ryhanschutz/robot_arm/cad/Mont1.SLDASM

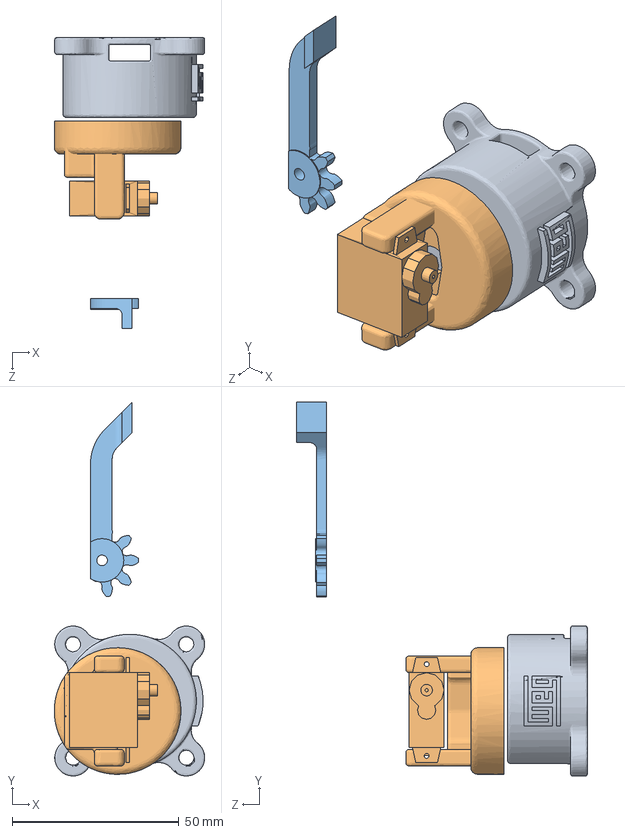
[picture p7: CAD file, 2026-10-29]
cad/Mont1.SLDASM
45.1 x 112.2 x 87.2 mm
base
tampa
garra_esquerda
