ryhanschutz/robot_arm/cad/Mont3.SLDASM

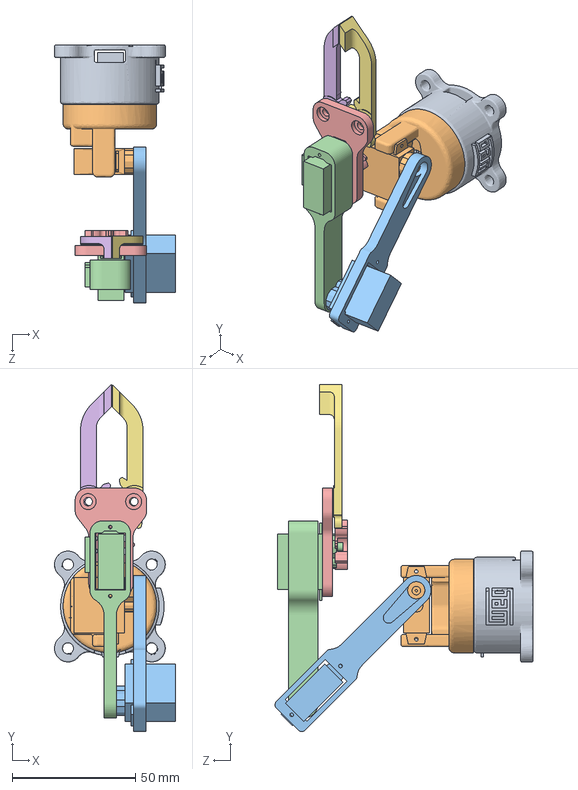
[picture p8: CAD file, 2026-10-29]
cad/Mont3.SLDASM
49.1 x 140.8 x 104.7 mm
base_Servo
tampa
braco_1
braco_2_correto
base_garra
garra_esquerda
garra_direita
