ryhanschutz/robot_arm/cad/garra_esquerda.SLDPRT

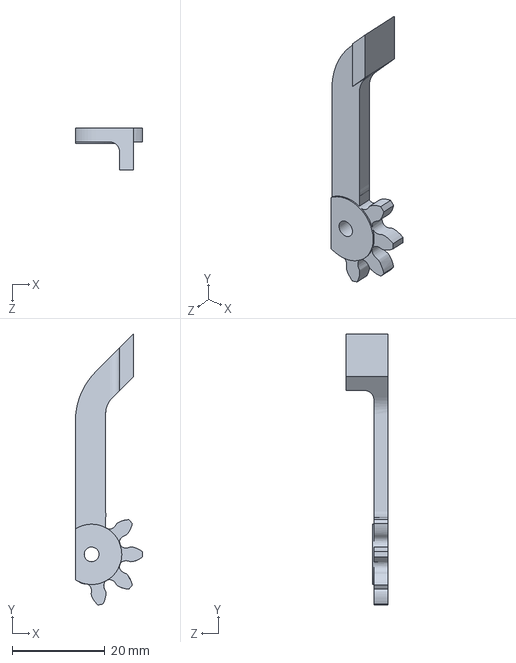
[picture p9: CAD file, 2026-10-29]
cad/garra_esquerda.SLDPRT
14.5 x 58.4 x 9.00 mm
