ryhanschutz/robot_arm/prints/case/caixa_weg.stl

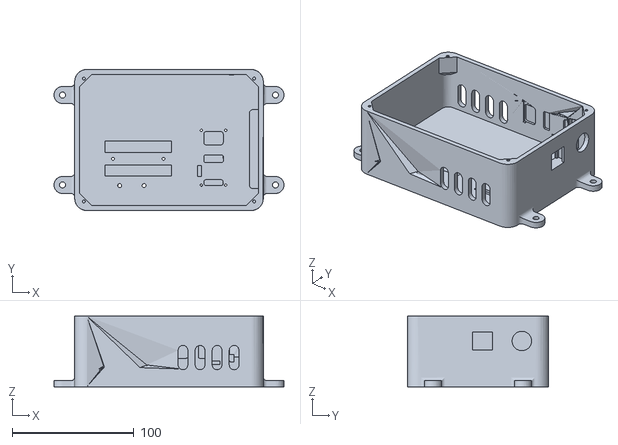
[picture p10: CAD file, 2026-10-29]
prints/case/caixa_weg.stl
189.0 x 115.9 x 58.0
