ryhanschutz/robot_arm/prints/robot/engrenagem_servo_v1.stl

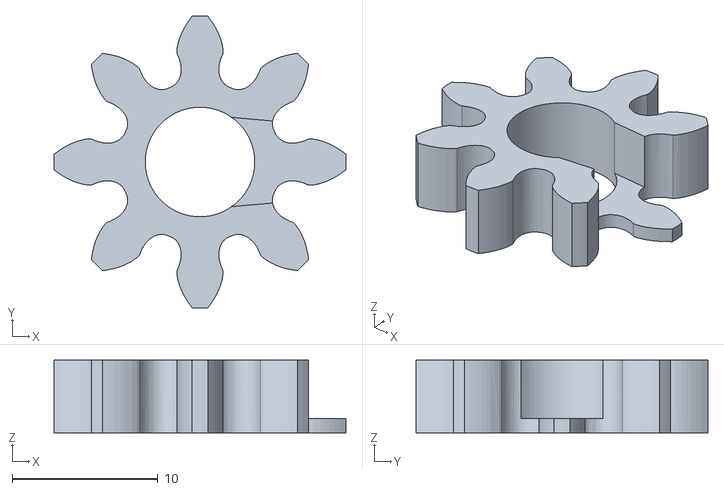
[picture p11: CAD file, 2026-10-29]
prints/robot/engrenagem_servo_v1.stl
20.0 x 20.0 x 5.00
