ryhanschutz/robot_arm/prints/robot/variants/base.stl

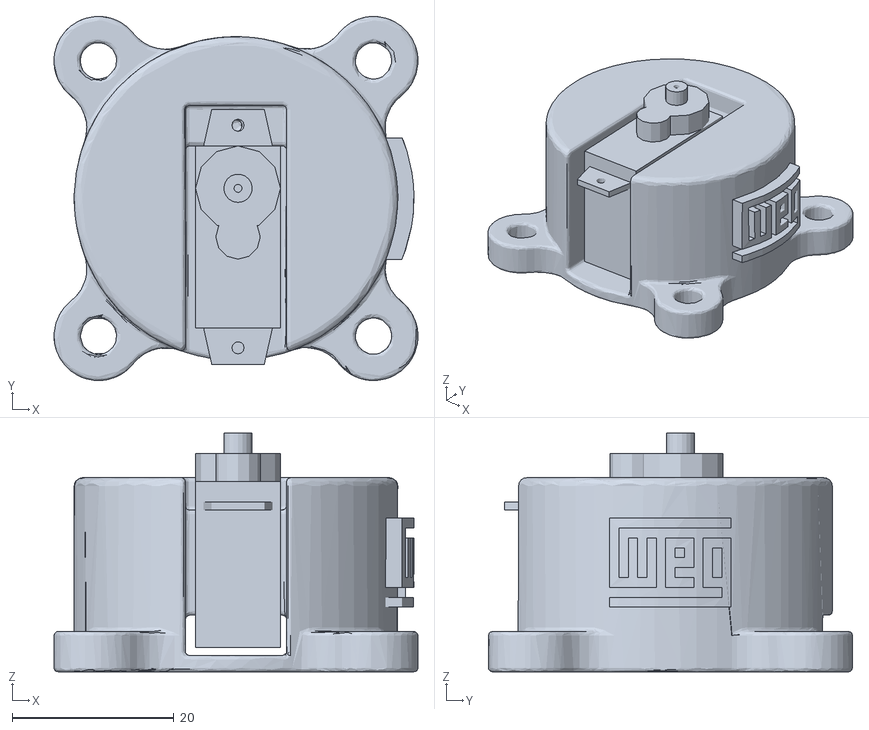
[picture p12: CAD file, 2026-10-29]
prints/robot/variants/base.stl
45.0 x 45.0 x 29.5
