ryhanschutz/robot_arm/cad/base.SLDPRT

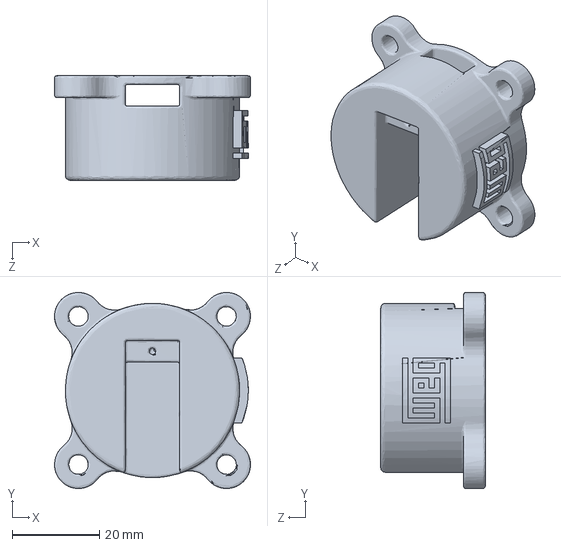
[picture p13: CAD file, 2026-10-29]
cad/base.SLDPRT
45.0 x 45.0 x 24.0 mm
