ryhanschutz/robot_arm/prints/case/tampa_weg.stl

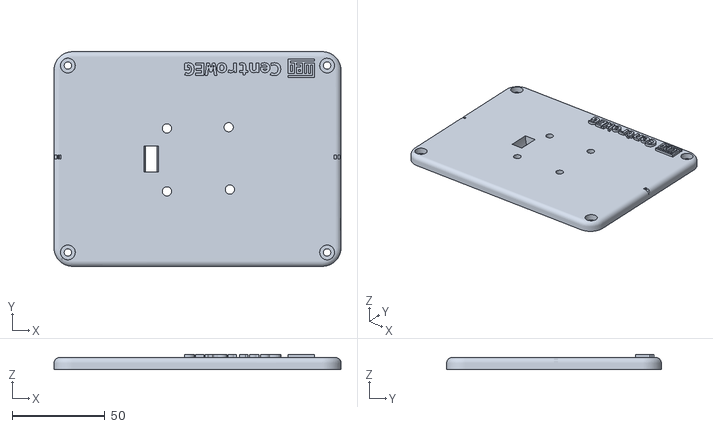
[picture p14: CAD file, 2026-10-29]
prints/case/tampa_weg.stl
155.0 x 115.9 x 8.15
