ryhanschutz/robot_arm/prints/robot/braco_2_v1.stl

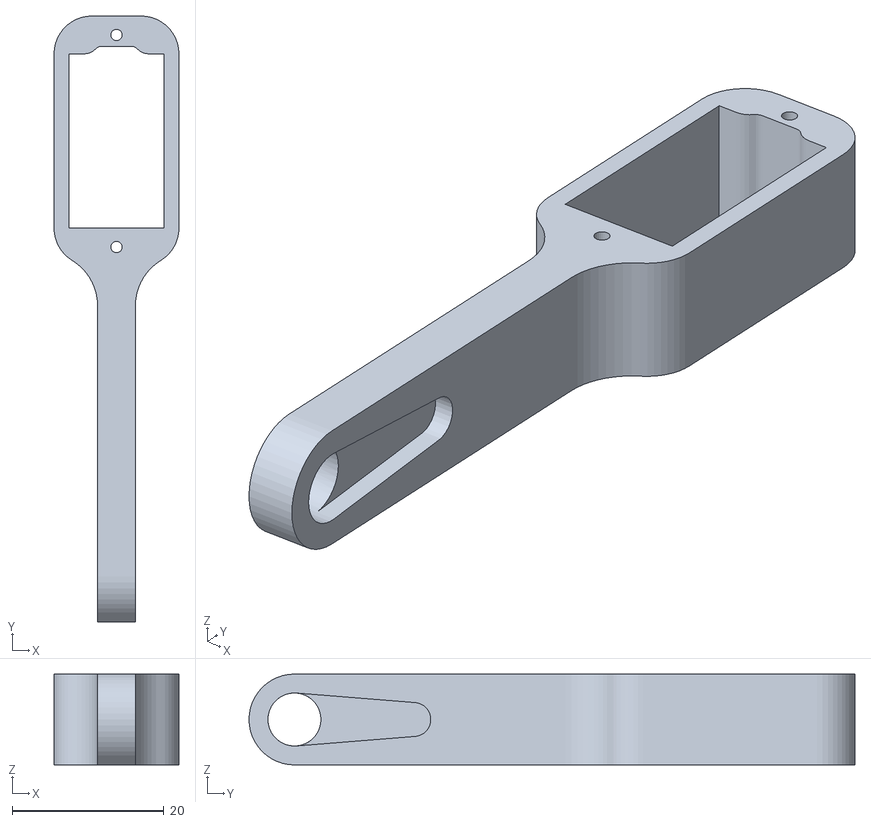
[picture p15: CAD file, 2026-10-29]
prints/robot/braco_2_v1.stl
16.5 x 80.0 x 12.0
