ryhanschutz/robot_arm/cad/tampa.SLDPRT

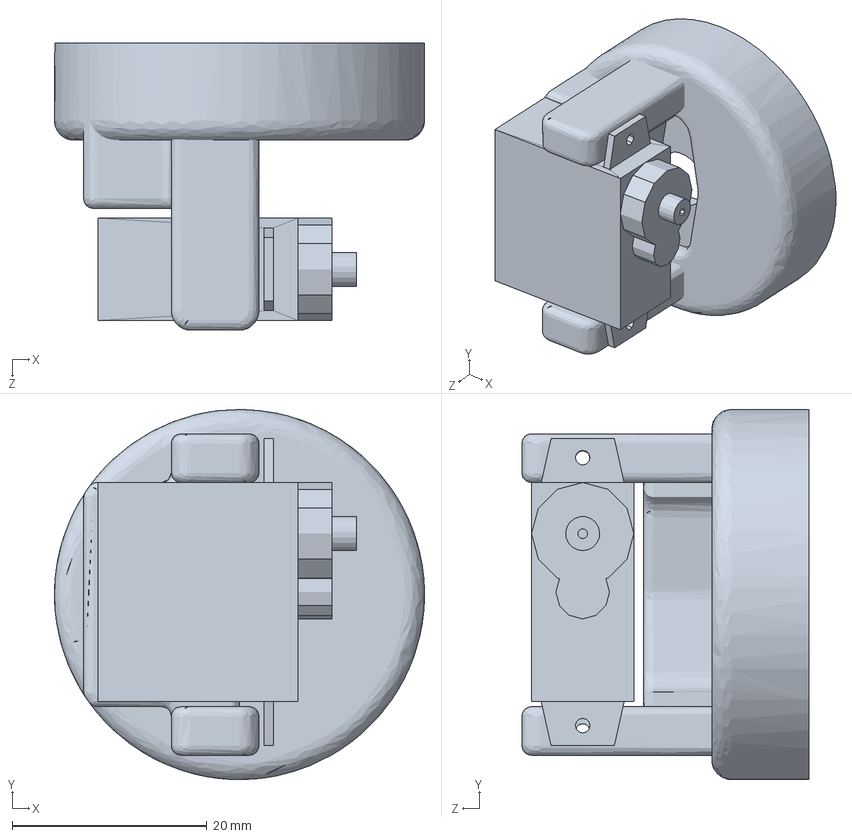
[picture p16: CAD file, 2026-10-29]
cad/tampa.SLDPRT
38.0 x 38.0 x 29.5 mm
