ryhanschutz/robot_arm/prints/robot/variants/base_modificada.stl

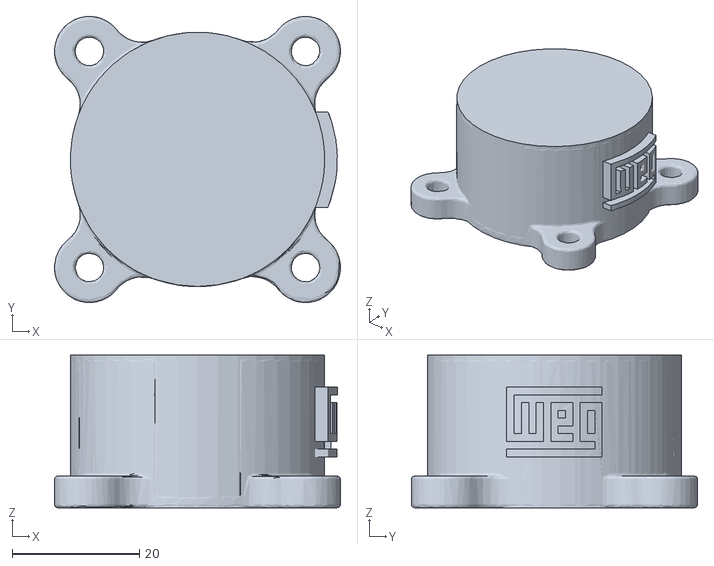
[picture p17: CAD file, 2026-10-29]
prints/robot/variants/base_modificada.stl
45.0 x 45.0 x 24.0
