ryhanschutz/robot_arm/prints/robot/braco_1_v1.stl

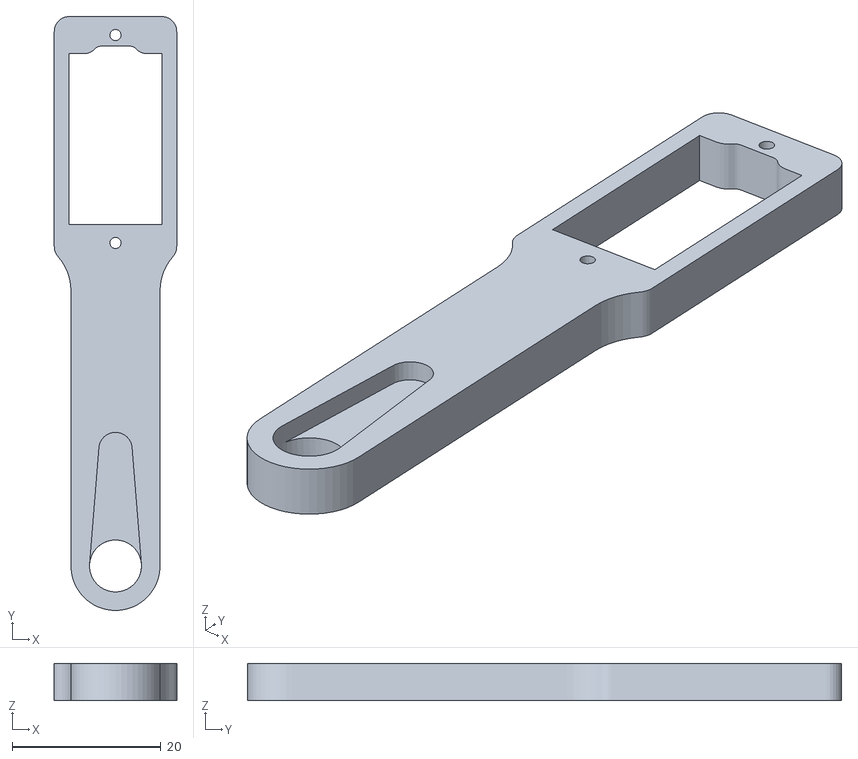
[picture p18: CAD file, 2026-10-29]
prints/robot/braco_1_v1.stl
16.5 x 80.0 x 5.00
