ryhanschutz/robot_arm/meshes/braco_2.stl

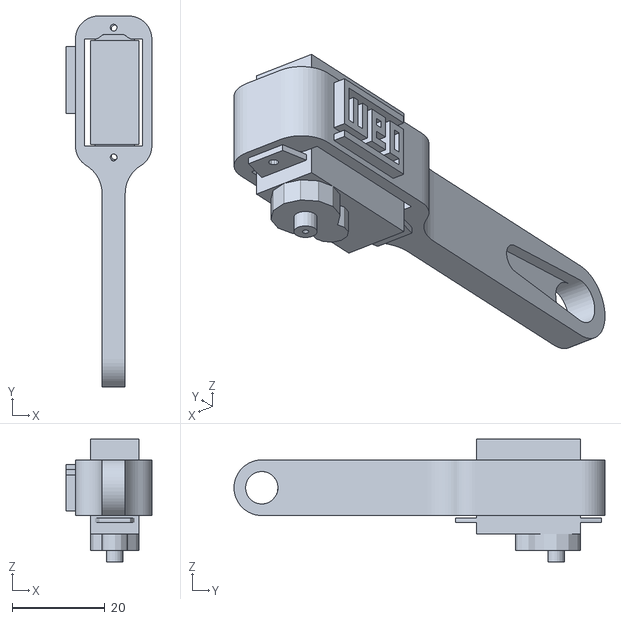
[picture p19: CAD file, 2026-10-29]
meshes/braco_2.stl
18.5 x 80.0 x 26.5
