ryhanschutz/robot_arm/prints/robot/suporte_garra_v1.stl

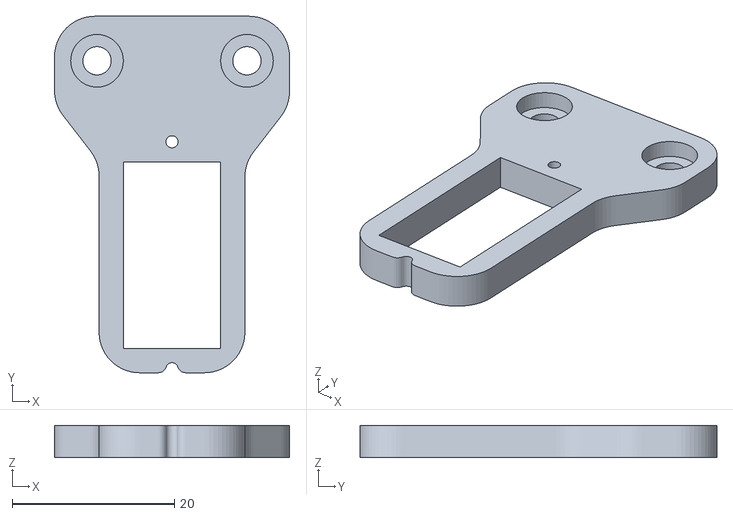
[picture p20: CAD file, 2026-10-29]
prints/robot/suporte_garra_v1.stl
29.0 x 44.0 x 4.00
