ryhanschutz/robot_arm/cad/braco_1.SLDPRT

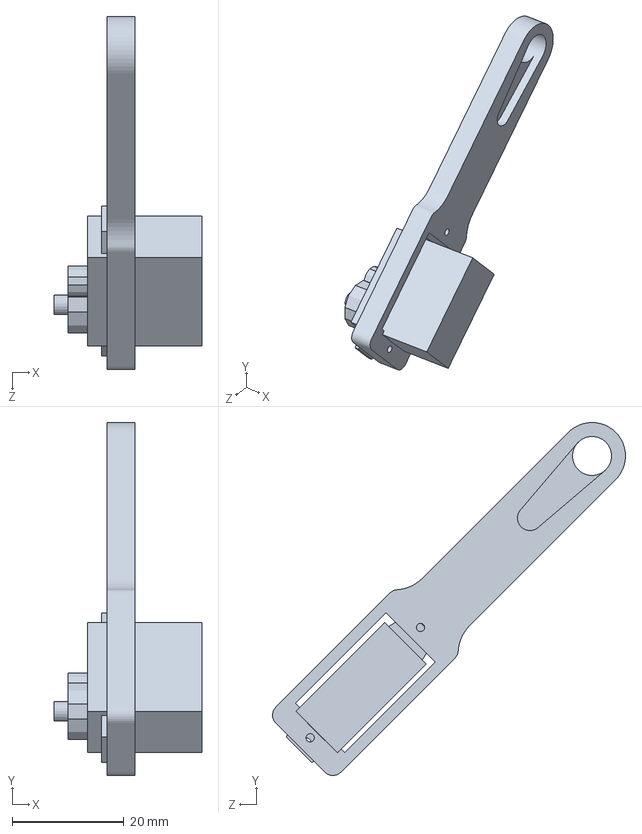
[picture p21: CAD file, 2026-10-29]
cad/braco_1.SLDPRT
26.5 x 63.3 x 63.3 mm
