ryhanschutz/robot_arm/cad/base_garra.SLDPRT

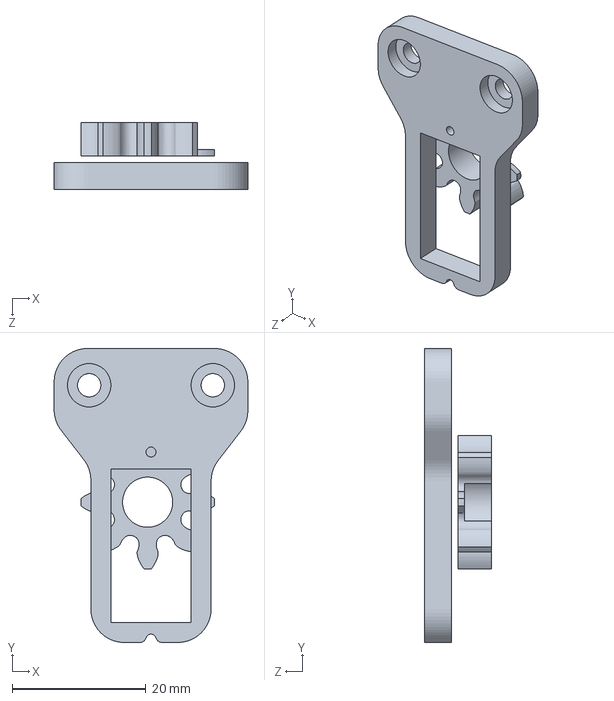
[picture p22: CAD file, 2026-10-29]
cad/base_garra.SLDPRT
29.0 x 44.0 x 10.0 mm
