ryhanschutz/robot_arm/prints/robot/engrenagem_garra_1_v1.stl

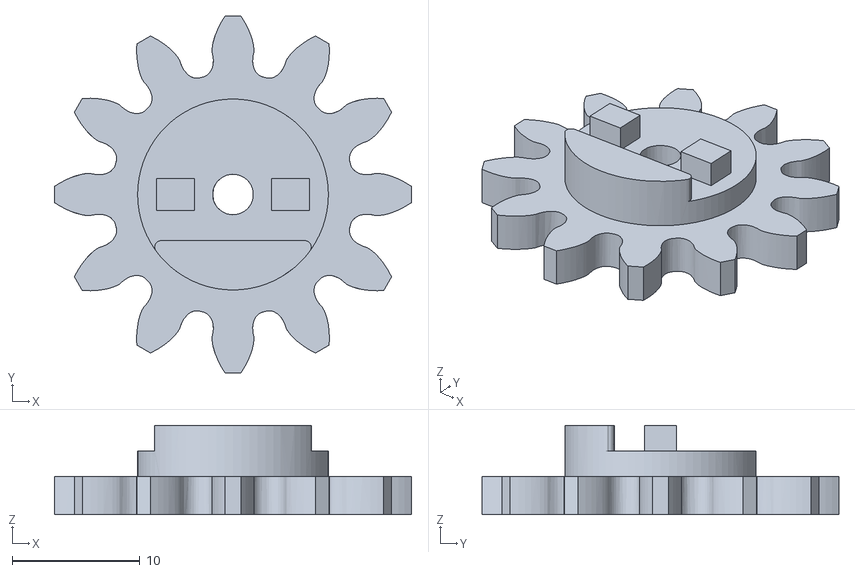
[picture p23: CAD file, 2026-10-29]
prints/robot/engrenagem_garra_1_v1.stl
28.0 x 28.0 x 7.00
