ryhanschutz/robot_arm/cad/braco_2_correto.SLDPRT

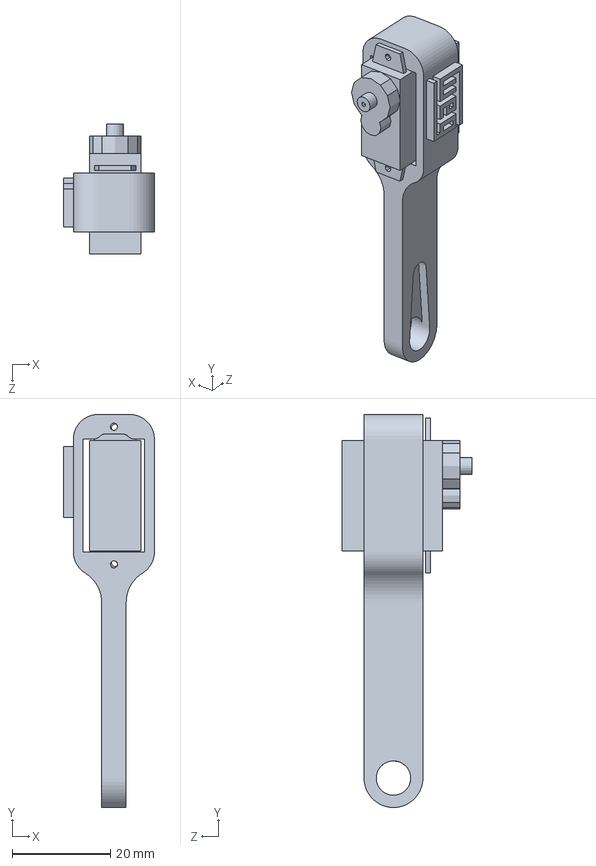
[picture p24: CAD file, 2026-10-29]
cad/braco_2_correto.SLDPRT
18.5 x 80.0 x 26.5 mm
