ryhanschutz/robot_arm/prints/robot/braco_2_weg_v1.stl

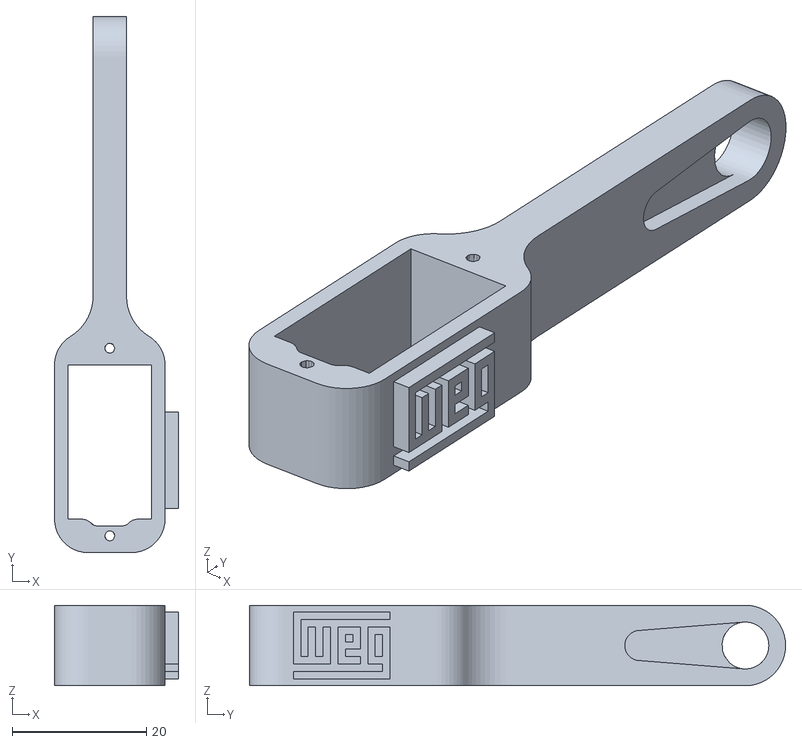
[picture p25: CAD file, 2026-10-29]
prints/robot/braco_2_weg_v1.stl
18.5 x 80.0 x 12.0
