ryhanschutz/robot_arm/prints/robot/tampa_v2.stl

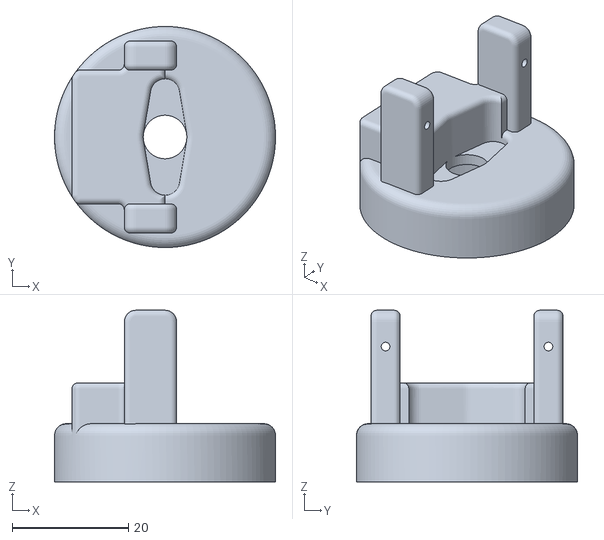
[picture p26: CAD file, 2026-10-29]
prints/robot/tampa_v2.stl
38.0 x 38.0 x 29.5
