ryhanschutz/robot_arm/cad/base_teste.SLDPRT

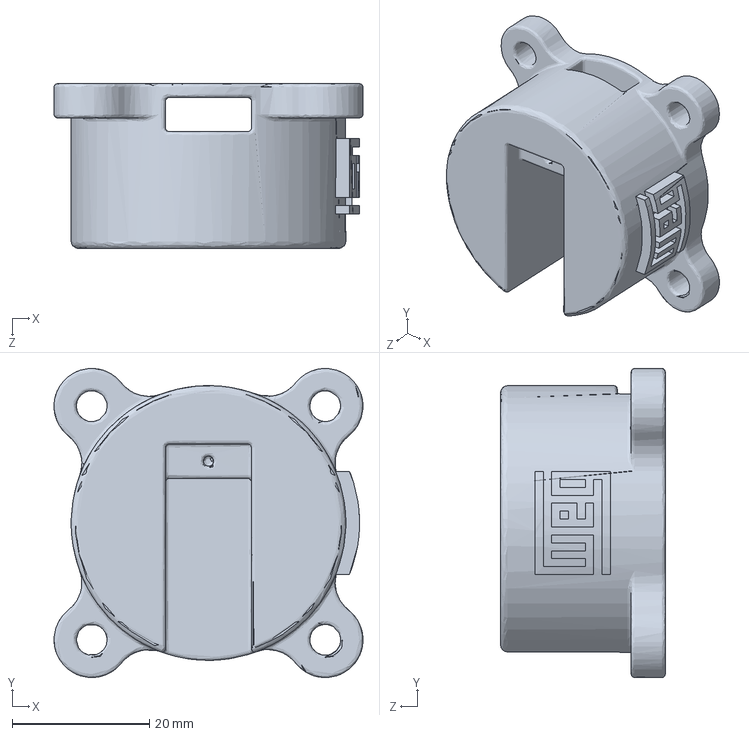
[picture p27: CAD file, 2026-10-29]
cad/base_teste.SLDPRT
45.0 x 45.0 x 24.0 mm
