ryhanschutz/robot_arm/(list of files, cad)

Other CAD files:
meshes/garra_esquerda.stl
meshes/base_servo.stl
prints/robot/variants/base_servo_1.stl
meshes/tampa.stl
prints/robot/garra_direita_v1.stl
cad/base_Servo.SLDPRT
meshes/garra_direita.stl
cad/garra_direita.SLDPRT
meshes/braco_1.stl
prints/robot/garra_esquerda_v1.stl
meshes/base_garra.stl
cad/base_modificada.SLDPRT
prints/robot/base_2_weg_v2.stl
cad/braco_2.SLDPRT
