ryhanschutz/robot_arm/(commit log)

2026-10-29 feat: add 3d models and CAD files for robotic arm project
    [Arm 2 WEG by Schutz.stl, Base 2 WEG by Schutz.stl, Brazo 1 v1.stl, Brazo 2 v1.stl, Mont1.SLDASM, Mont3 - base_Servo-1.STL, Mont3 - base_garra-1.STL, Mont3 - braco_1-1.STL]
2026-10-30 refactor: reorganize repo (models, meshes, sim, prints, cad, firmware, docs); trash legacy
    [Arm 2 WEG by Schutz.stl, Base 2 WEG by Schutz.stl, Brazo 1 v1.stl, Brazo 2 v1.stl, Mont1.SLDASM, Mont3.SLDASM, Pinza derecha v1.stl, Pinza izquierda v1.stl]
2026-10-30 feat: add robot arm digital twin simulation, firmware, and documentation assets
2026-10-30 feat: add interactive 4-DOF robot arm simulation in MuJoCo
2026-10-31 refactor: restructure workspace by archiving legacy cad models and adding technical architecture guide
    [Mont1.SLDASM, Mont3.SLDASM, base_Servo.SLDPRT, base_garra.SLDPRT, braco_1.SLDPRT, braco_2_correto.SLDPRT, garra_direita.SLDPRT, garra_esquerda.SLDPRT]
